lukasznowarkiewicz/SiliconeHeater-HeatingGloves/Design files/1 drawing/Hand drawing.pdf

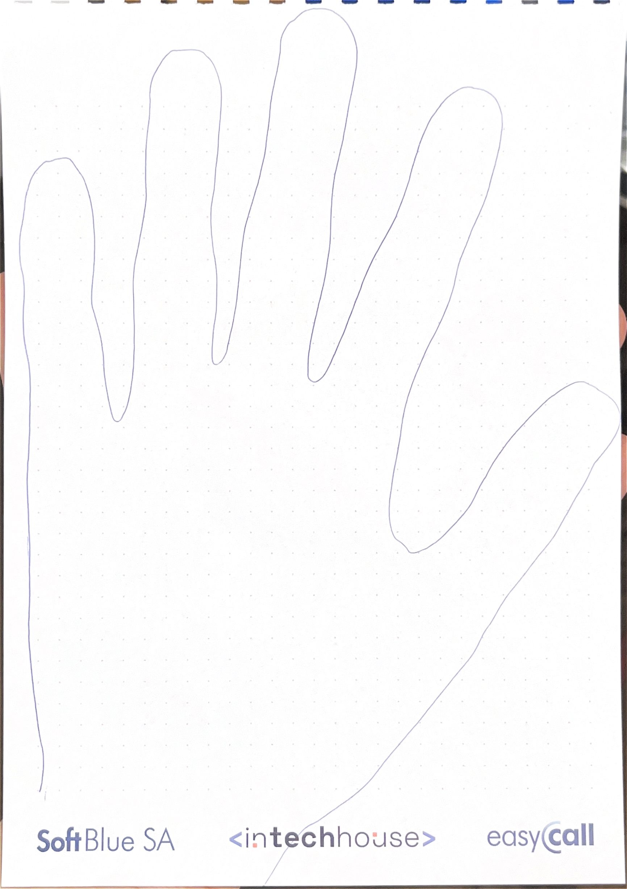
[picture p24: page 1]
