lukasznowarkiewicz/SiliconeHeater-HeatingGloves/Design files/3 altium/Tool for routing.xlsx

Known values |  |  |  | Defined quantities
Resistance | R | 10 | Ω | Heating area length | 100 | mm
Resistivity | ρ | 0.00142 | Ω·mm | Heating area width | 100 | mm
Material thickness | d | 0.03 | mm | Number of heating wire groups | 1 | Set
Ratio | L/W | 211.27 | / | Assumed line width | 3.5 | mm
 |  |  |  | Line length | 739.4366197 | mm
Results
Horizontal routing |  |  | Vertical routing
Number of routable lines | 8 | Piece | Number of routable lines | 8 | Piece
Centerline spacing | 14.28571 | mm | Centerline spacing | 14.28571 | mm
Heating wire spacing | 10.78571 | mm | Heating wire spacing | 10.78571 | mm
Half centerline spacing | 7.1429 | mm |  | 7.1429 | mm |  | Material | Thickness (mm) | Resistivity (Ω·mm)
 |  |  |  |  |  |  | Copper (CU) | 0.03 | 6.7e-05
Calculated line width (reverse calculation) |  |  |  |  |  |  | Copper (CU) | 0.05 | 6.7e-05
Actual line length | 730 | mm |  |  |  |  | STS（SUS304) | 0.03 | 0.00073
Line width | 3.45533 | mm |  |  |  |  | STS（SUS304) | 0.05 | 0.00073
Half line width | 1.72767 | mm |  |  |  |  | FeCrAl | 0.03 | 0.00142
Resistivity | Line length | Line width | Material thickness |  | Resistance
0.00142 | 730 | 3.45 | 0.03 |  | 10.01545894
