lukasznowarkiewicz/SiliconeHeater-HeatingGloves/Design files/2 kicad/flexible-hand-warmer-left-custom-traces/outputs/flexible-hand-warmer-left-F_Cu.dxf

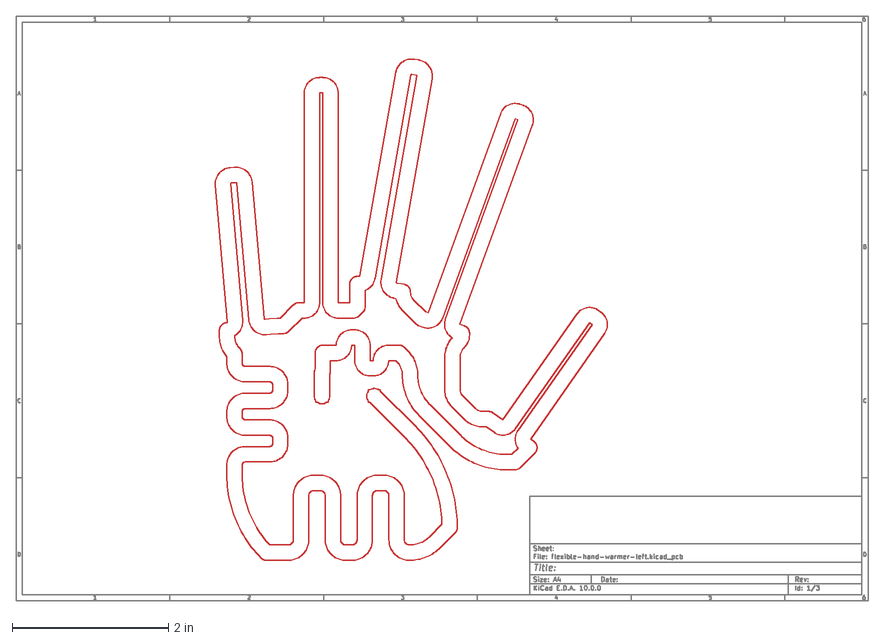
[picture p25: CAD file, 2026-05-16]
Design files/2 kicad/flexible-hand-warmer-left-custom-traces/outputs/flexible-hand-warmer-left-F_Cu.dxf
10.9 x 7.48 in
