lukasznowarkiewicz/SiliconeHeater-HeatingGloves/Design files/2 kicad/flexible-hand-warmer-left/dxf/flexible-hand-warmer-left.dxf

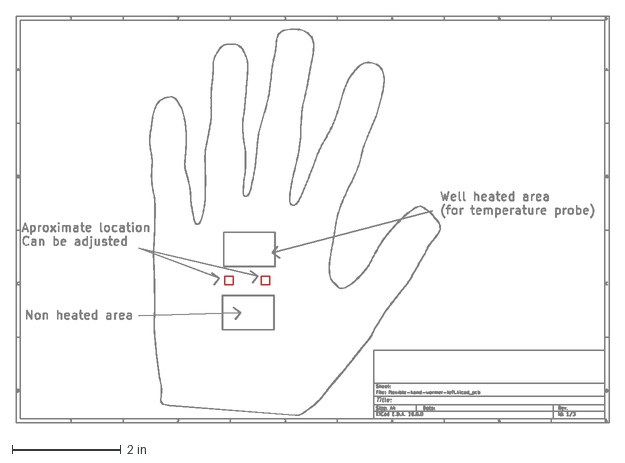
[picture p26: CAD file, 2026-05-16]
Design files/2 kicad/flexible-hand-warmer-left/dxf/flexible-hand-warmer-left.dxf
10.9 x 7.48 in
