lukasznowarkiewicz/SiliconeHeater-HeatingGloves/Design files/3 altium/Imported flexible-hand-warmer-left/Project Outputs for flexible-hand-warmer-left/converted to dxf from gerbers/flexible-hand-warmer-left_Copper_Signal_Top.dxf

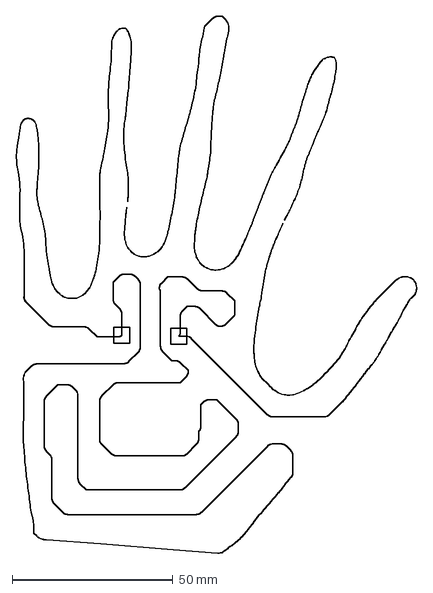
[picture p27: CAD file, 2026-05-16]
Design files/3 altium/Imported flexible-hand-warmer-left/Project Outputs for flexible-hand-warmer-left/converted to dxf from gerbers/flexible-hand-warmer-left_Copper_Signal_Top.dxf
124.5 x 167.1 mm
