lukasznowarkiewicz/SiliconeHeater-HeatingGloves/Design files/3 altium/Imported flexible-hand-warmer-left/Project Outputs for flexible-hand-warmer-left/flexible-hand-warmer-left_2.DXF

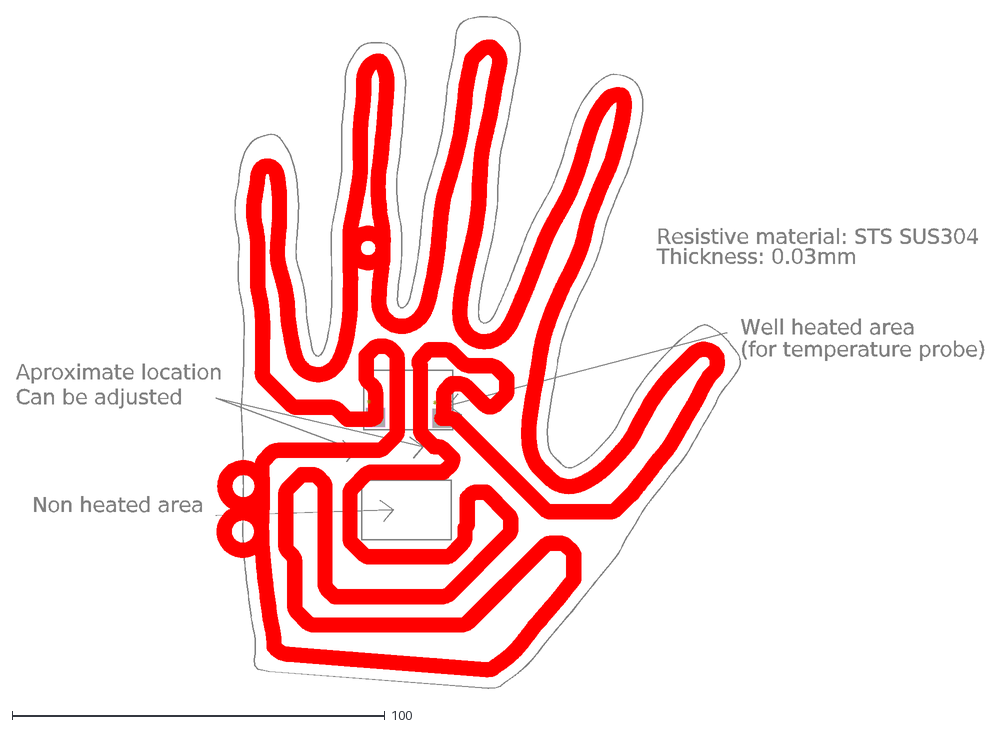
[picture p28: CAD file, 2026-05-16]
Design files/3 altium/Imported flexible-hand-warmer-left/Project Outputs for flexible-hand-warmer-left/flexible-hand-warmer-left_2.DXF
(for temperature probe)
Well heated area
Non heated area
Thickness: 0.03mm
Resistive material: STS SUS304
Can be adjusted
Aproximate location
*
