lukasznowarkiewicz/SiliconeHeater-HeatingGloves/Design files/4 altium - kicad/kicad conversion/outputs/flexible-hand-warmer-left-F_Cu.dxf

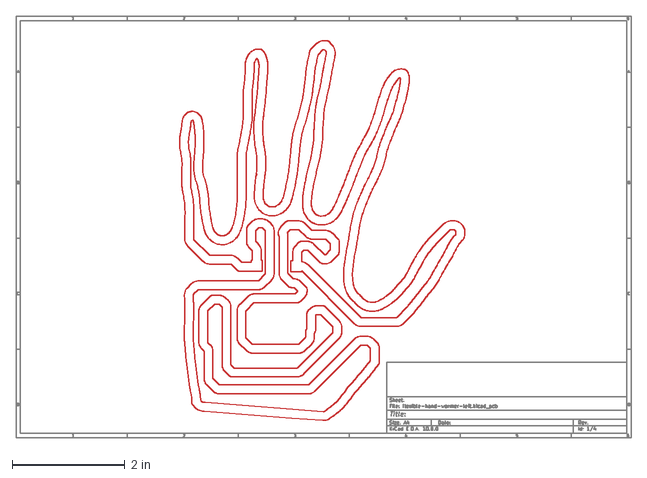
[picture p29: CAD file, 2026-05-16]
Design files/4 altium - kicad/kicad conversion/outputs/flexible-hand-warmer-left-F_Cu.dxf
10.9 x 7.48 in
