lukasznowarkiewicz/SiliconeHeater-HeatingGloves/Design files/1 drawing/hand_drawing_continuous_line.dxf

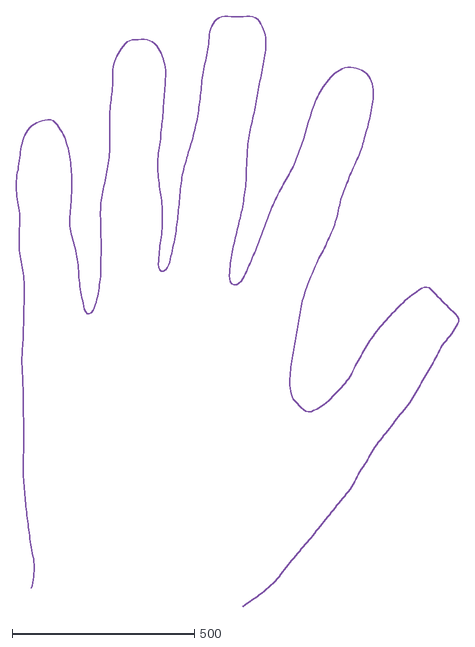
[picture p30: CAD file, 2026-05-16]
Design files/1 drawing/hand_drawing_continuous_line.dxf
1213.6 x 1619.2
