lukasznowarkiewicz/SiliconeHeater-HeatingGloves/Design files/3 altium/Imported flexible-hand-warmer-left/Project Outputs for flexible-hand-warmer-left/flexible-hand-warmer-left.step

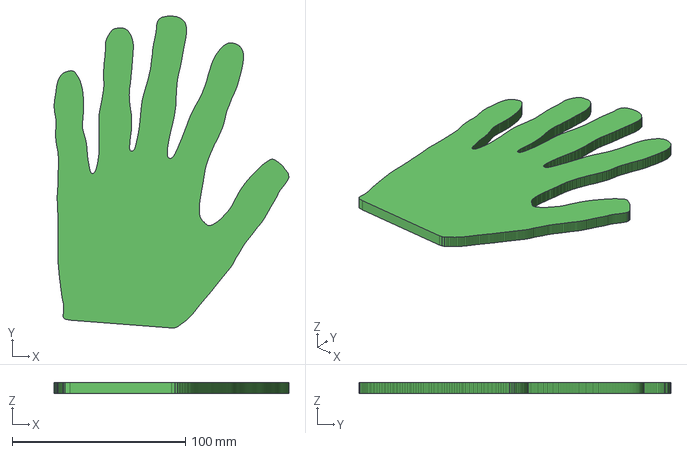
[picture p32: CAD file, 2026-05-16]
Design files/3 altium/Imported flexible-hand-warmer-left/Project Outputs for flexible-hand-warmer-left/flexible-hand-warmer-left.step
135.6 x 180.3 x 6.10 mm
