lukasznowarkiewicz/SiliconeHeater-HeatingGloves/Design files/2 kicad/flexible-hand-warmer-left-custom-traces/outputs/flexible-hand-warmer-left-Edge_Cuts.dxf

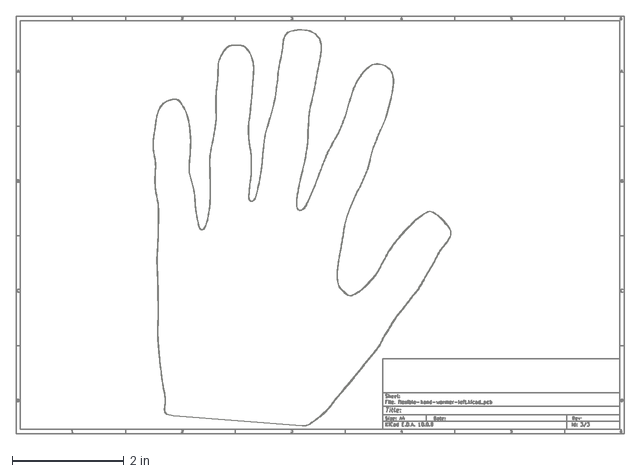
[picture p34: CAD file, 2026-05-16]
Design files/2 kicad/flexible-hand-warmer-left-custom-traces/outputs/flexible-hand-warmer-left-Edge_Cuts.dxf
10.9 x 7.48 in
