lukasznowarkiewicz/SiliconeHeater-HeatingGloves/Design files/1 drawing/hand_drawing_continuous_line copy.dxf

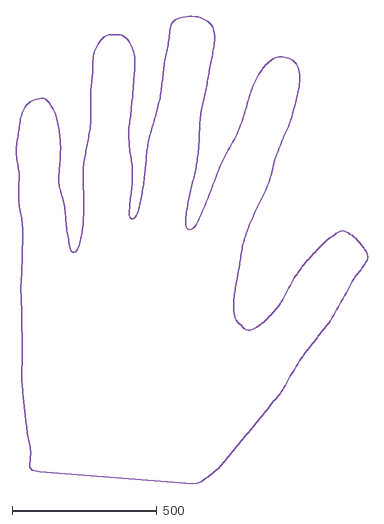
[picture p35: CAD file, 2026-05-16, an earlier design]
Design files/1 drawing/hand_drawing_continuous_line copy.dxf
1213.6 x 1613.6
