lukasznowarkiewicz/SiliconeHeater-HeatingGloves/(list of files, cad)

Other CAD files:
Design files/3 altium/Imported flexible-hand-warmer-left/Project Outputs for flexible-hand-warmer-left/flexible-hand-warmer-left.DXF
