lukasznowarkiewicz/SiliconeHeater-HeatingGloves/Design files/4 altium - kicad/kicad conversion/outputs/flexible-hand-warmer-left-Edge_Cuts.pdf

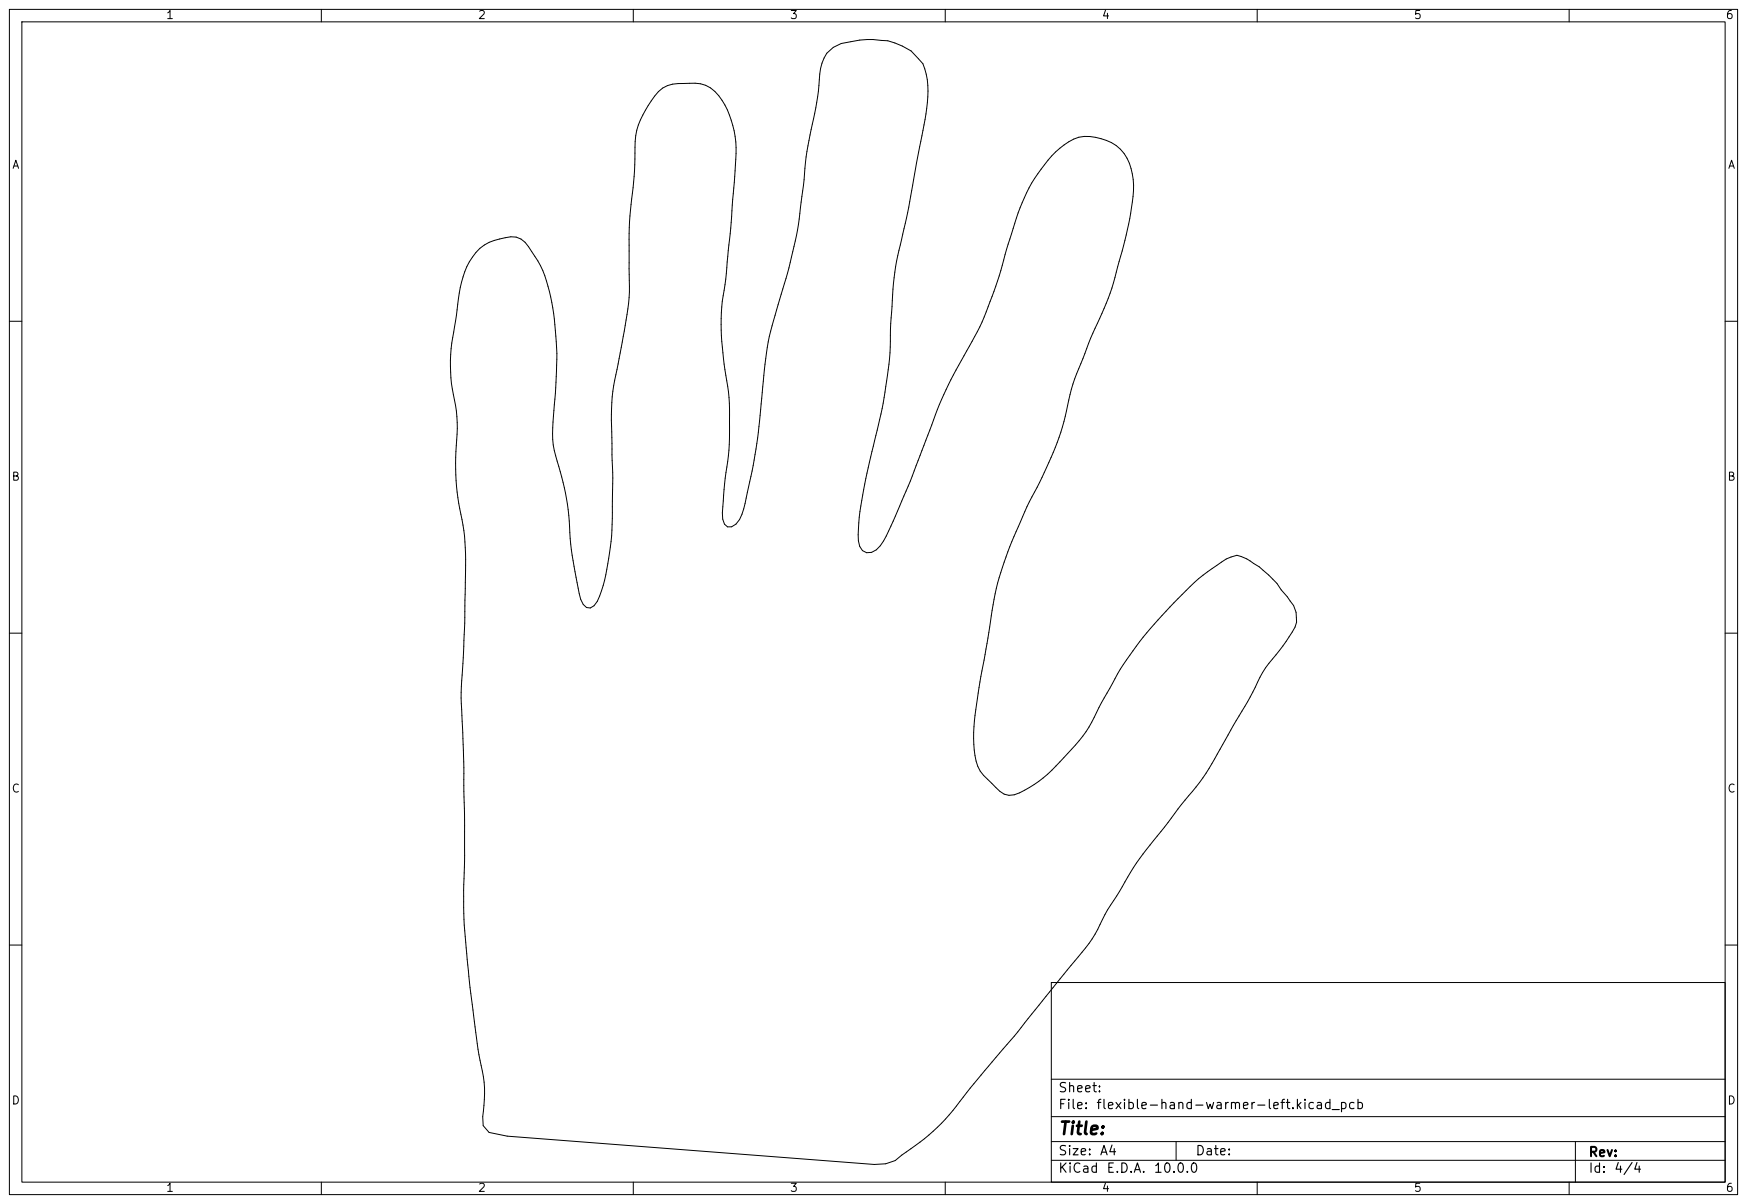
[picture p36: page 1]

Sheet:
File: flexible-hand-warmer-left.kicad_pcb
Title:

Size: A4 | Rev:
KiCad E.D.A. 10.0.0 | Id: 4/4
