lukasznowarkiewicz/SiliconeHeater-HeatingGloves/Design files/1 drawing/hand_drawing_vector.pdf

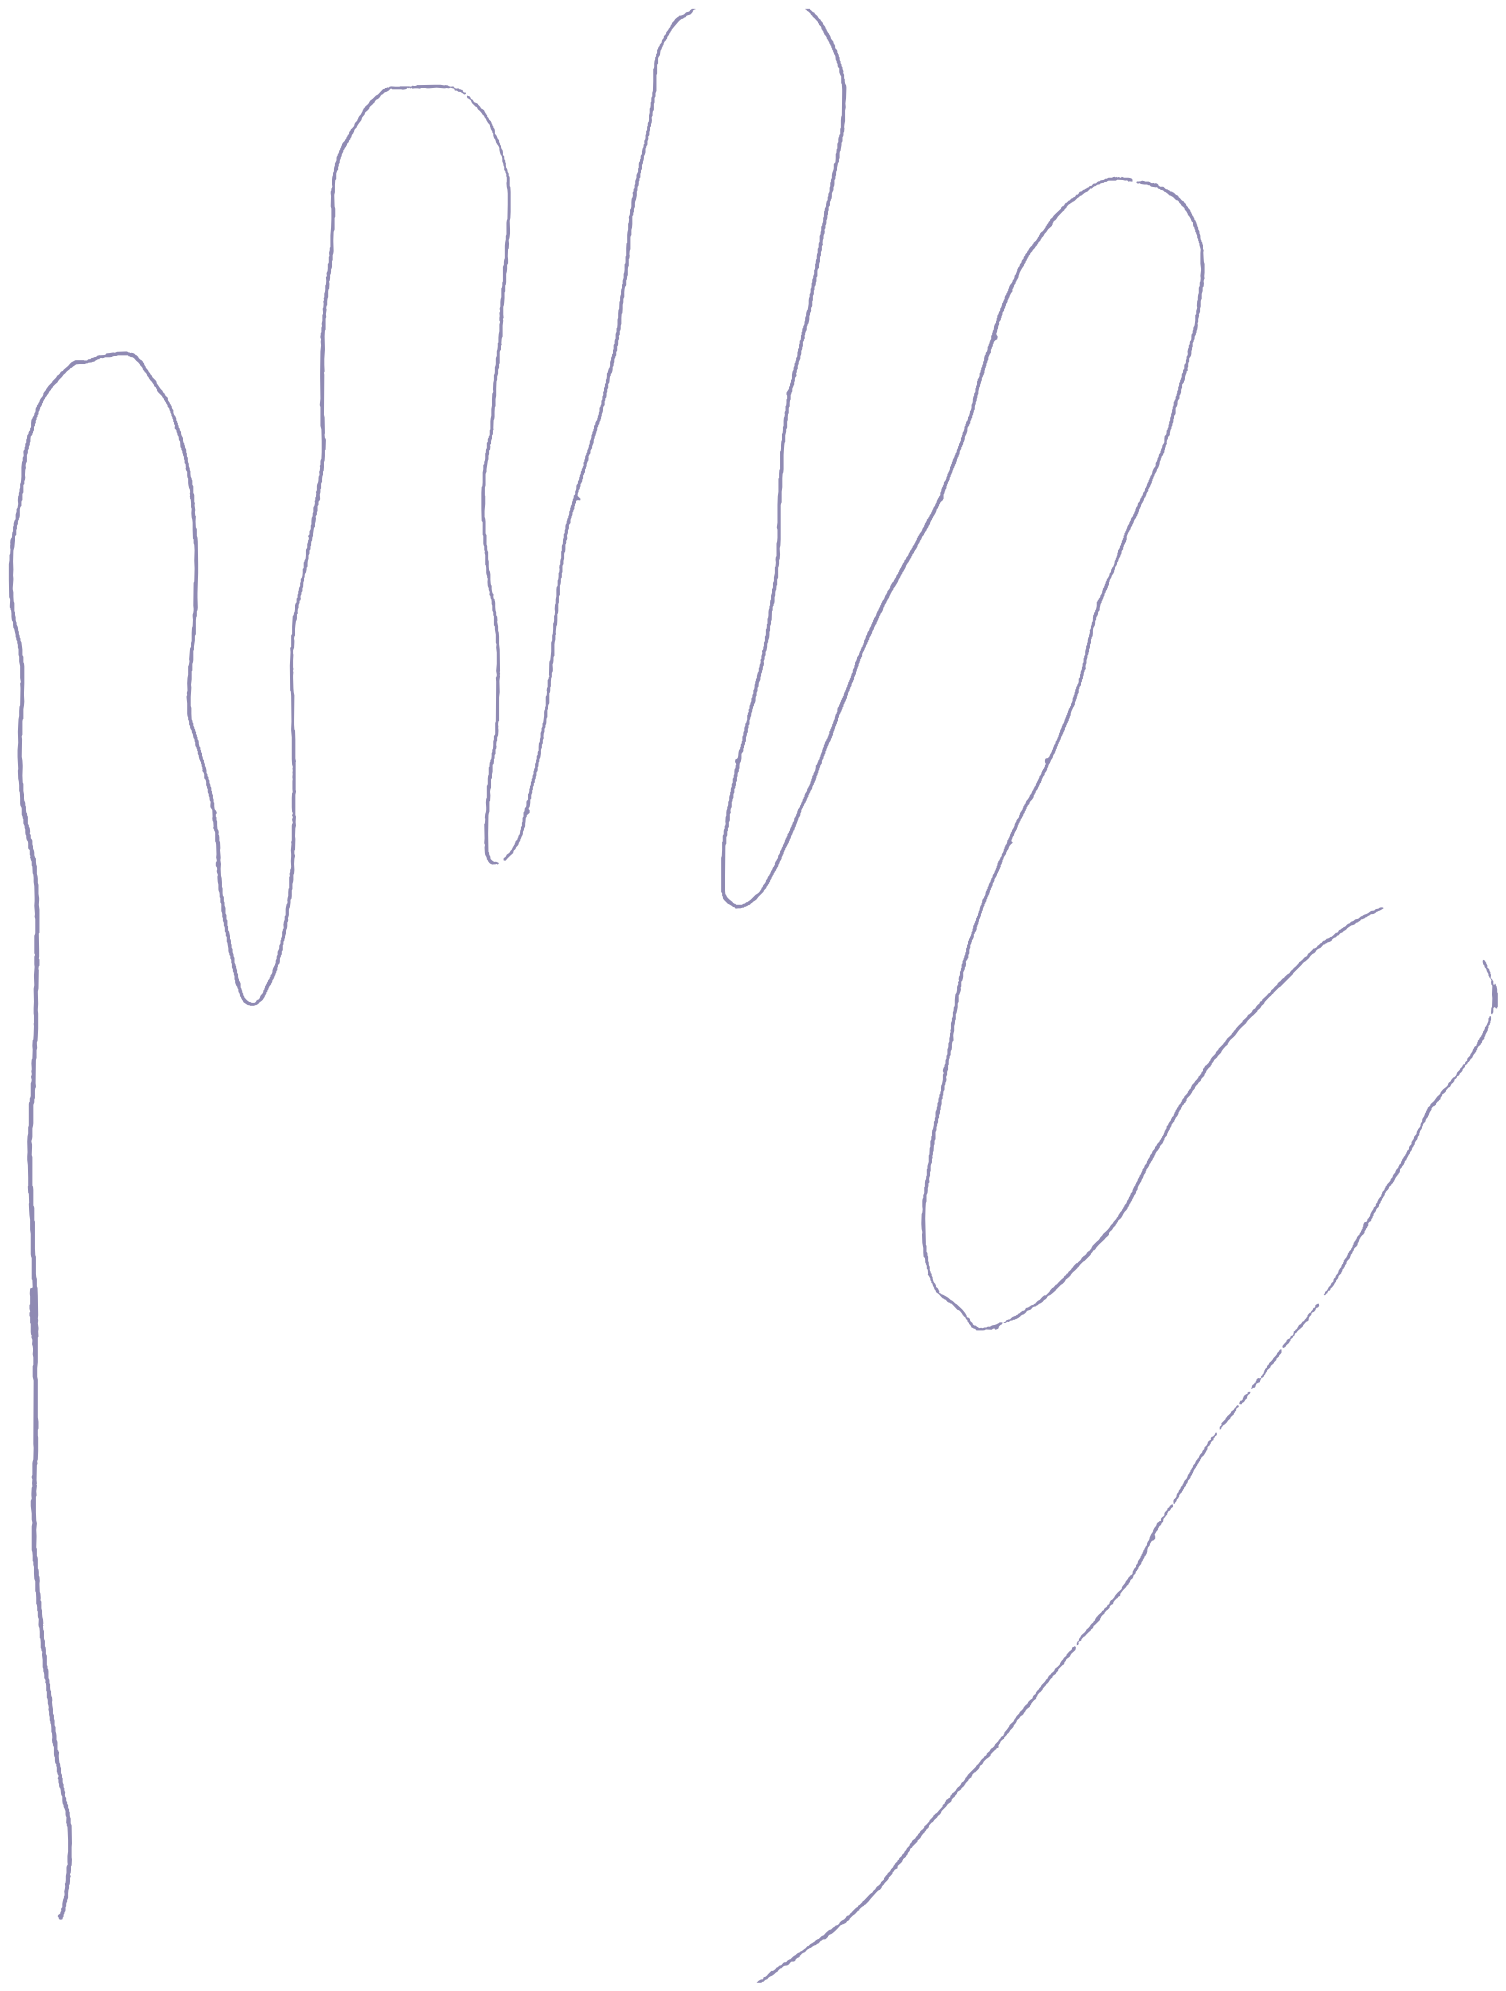
[picture p37: page 1]
