lukasznowarkiewicz/SiliconeHeater-HeatingGloves/Design files/3 altium/Imported flexible-hand-warmer-left/flexible-hand-warmer-left.pdf

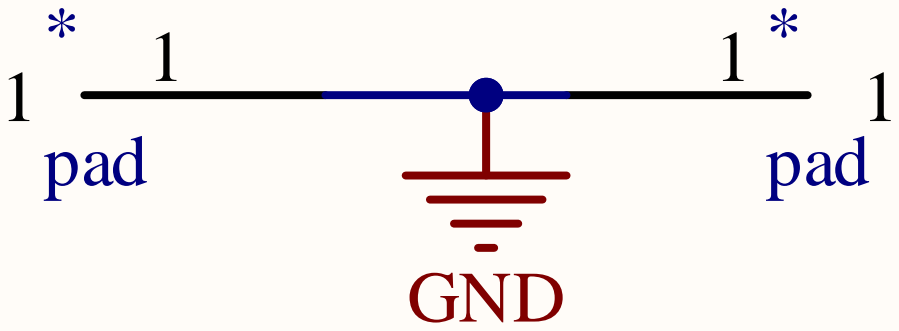
[picture p38: page 1]

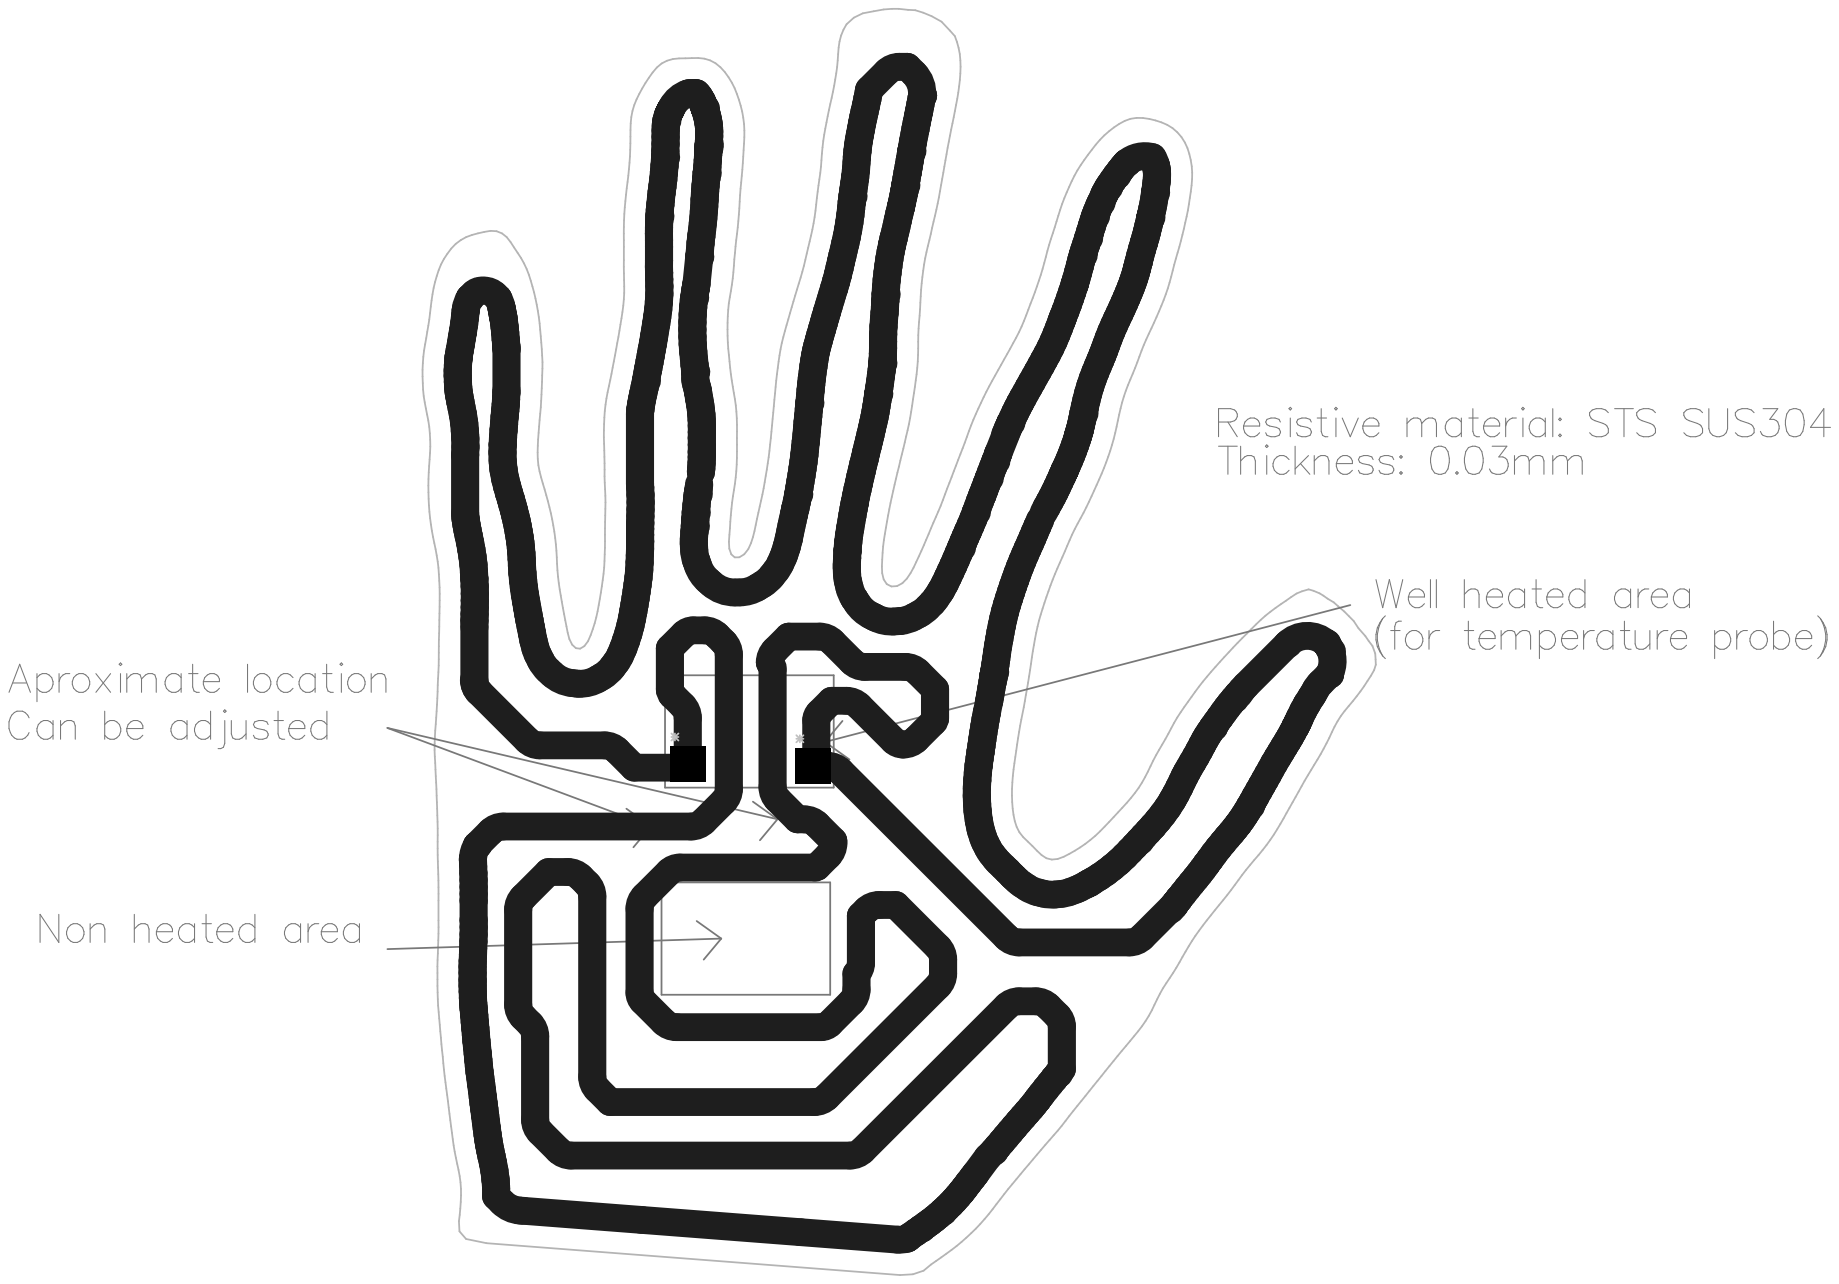
[picture p39: page 2]
