lukasznowarkiewicz/SiliconeHeater-HeatingGloves/(list of files, drawings)

Other design files:
Design files/3 altium/Imported flexible-hand-warmer-left/flexible-hand-warmer-left.PcbDoc
Design files/3 altium/Imported flexible-hand-warmer-left/flexible-hand-warmer-left.PrjPcb
Design files/3 altium/Imported flexible-hand-warmer-left/PcbLib1.PcbLib
Design files/3 altium/Imported flexible-hand-warmer-left/Schlib1.SchLib
Design files/3 altium/Imported flexible-hand-warmer-left/Sheet1.SchDoc
Design files/4 altium - kicad/kicad conversion/Schlib1.SchLib
